lingoslinger/LEDLightBar/README.md

# LEDLightBar

An OpenSCAD file (and collection of STLs) for a race car number light bar. Please see the PDF for more info (for now.)
