lingoslinger/LEDLightBar/LEDHolder_155_25_15_plug.stl

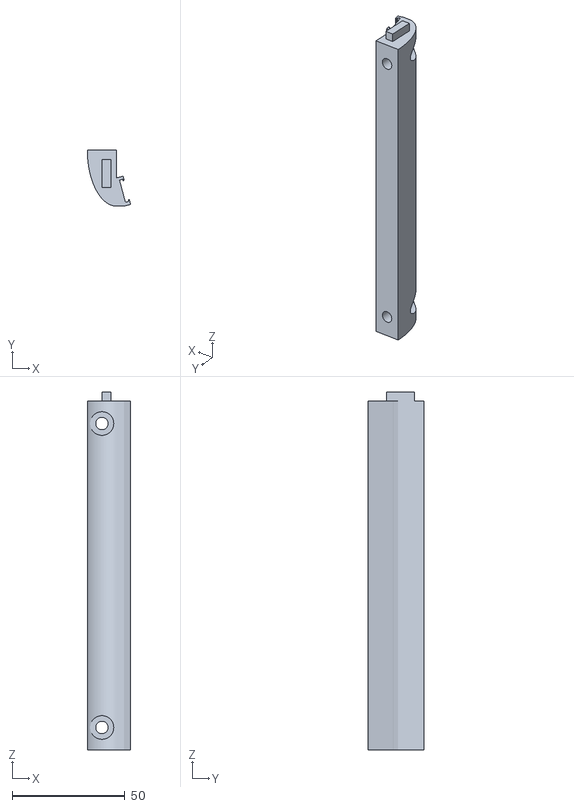
[picture p5: CAD file, 2024-07-07]
LEDHolder_155_25_15_plug.stl
19.3 x 25.0 x 159.0
