lingoslinger/LEDLightBar/LEDHolder_top_220.stl

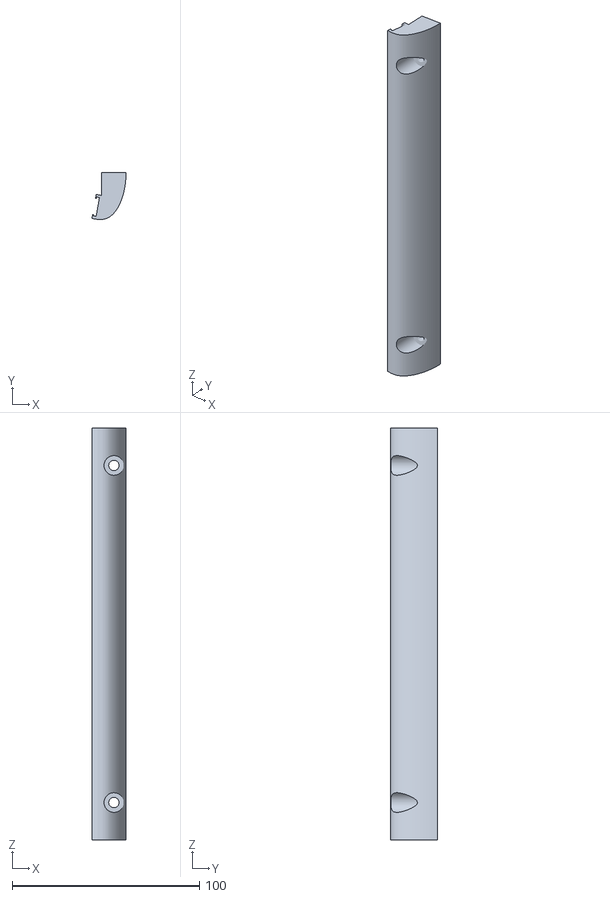
[picture p6: CAD file, 2024-07-07]
LEDHolder_top_220.stl
18.2 x 25.0 x 220.0
