lingoslinger/LEDLightBar/LEDHolder_155_40_15_socket.stl

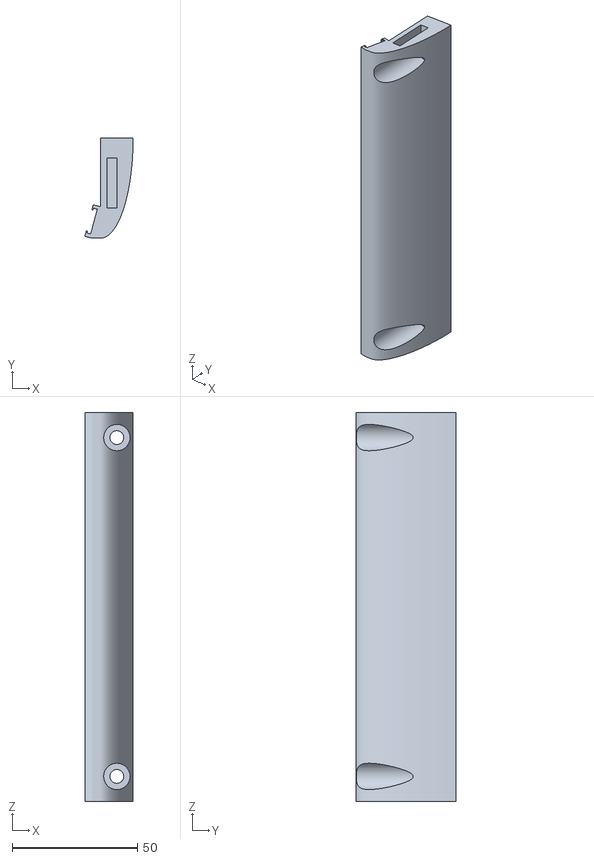
[picture p7: CAD file, 2023-08-26]
LEDHolder_155_40_15_socket.stl
19.3 x 40.0 x 155.0
