lingoslinger/LEDLightBar/LEDHolder_drillingtemplate.stl

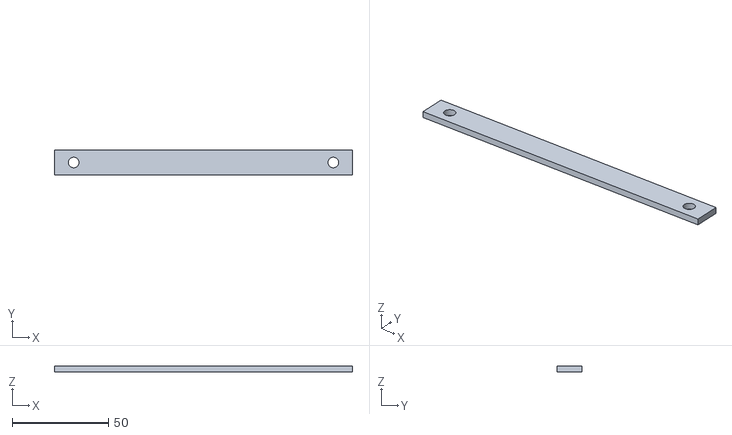
[picture p8: CAD file, 2023-08-26]
LEDHolder_drillingtemplate.stl
155.0 x 13.0 x 3.00
