lingoslinger/LEDLightBar/(list of files, cad)

Other CAD files:
LEDHolder_155_25_15_socket.stl
LEDHolder_155_40_15_plug.stl
