lingoslinger/LEDLightBar/(commit log)

2023-08-26 initial commit with STL files for car 403
    [LEDHolder.scad, LEDHolder_155_40_15_plug.stl, LEDHolder_155_40_15_socket.stl, LEDHolder_drillingtemplate.stl]
2023-08-27 cleaned up a few things; prep for single part bracket implementation
    [LEDHolder.scad]
2024-07-07 additional lengths; updated notes
    [LEDHolder.scad, LEDHolder_155_25_15_plug.stl, LEDHolder_155_25_15_socket.stl, LEDHolder_top_220.stl]
